cbm-instructions/entente-arduino/pictures/10.jpg

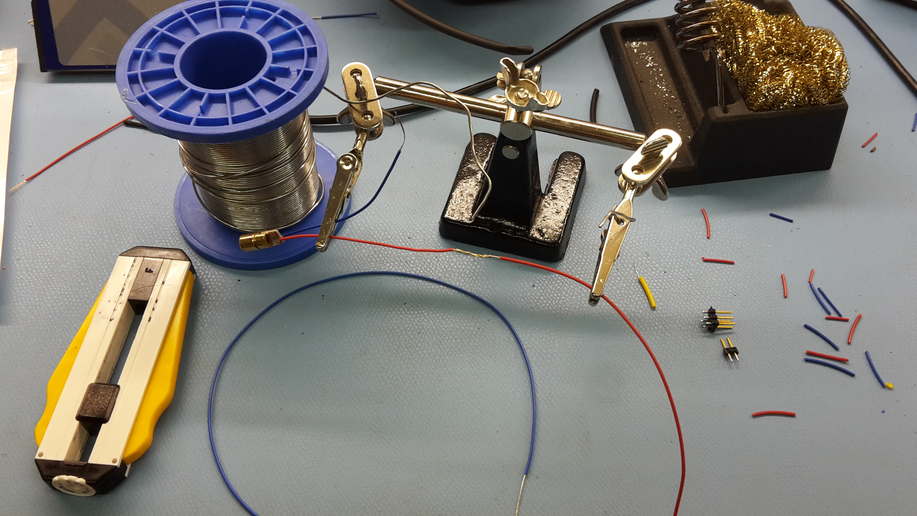
pictures/10.jpg
