cbm-instructions/entente-arduino/pictures/13.jpg

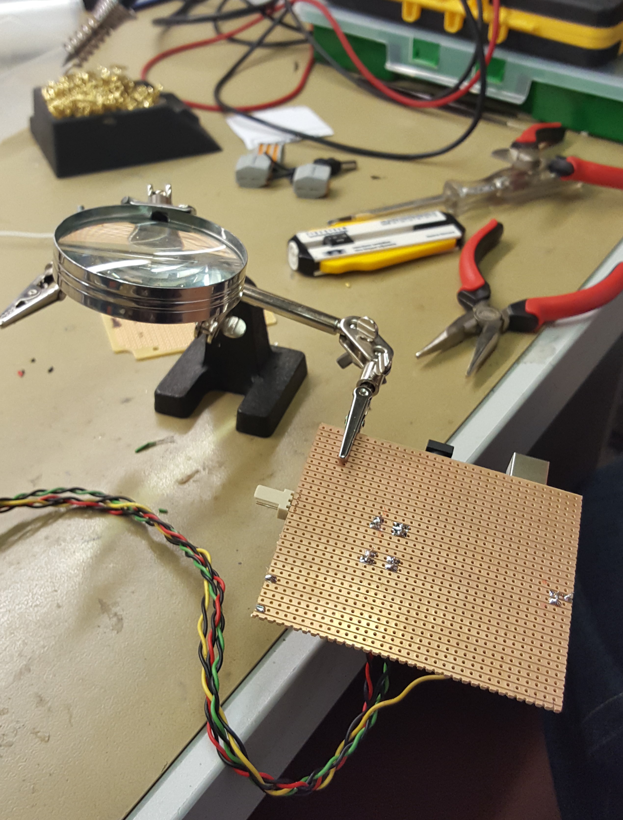
pictures/13.jpg
