cbm-instructions/entente-arduino/(commit log)

2016-06-11 add libraries and driver vor laser pc
2016-06-14 rework driver
2016-06-14 lazzor driver v2
2016-06-21 name change and new high pin
